livus/bimfo/enclosure/decals/decals.tex

% Decal sheet for the stop display replica, printed 1:1 on A4.
% Build: python make_matrix.py && xelatex decals.tex   (needs tikz, fontspec, pifont; run xelatex
% twice on a fresh checkout: the pages are placed with remember picture)
% All sizes in mm and taken from wl_display.scad; see the notes at each item.
% Font: Liberation Sans (fonts/, SIL OFL), the font the model engraves its labels in.
\documentclass{article}
\usepackage[a4paper, margin=0mm]{geometry}
\usepackage{tikz}
\usepackage{pifont}
\usepackage{graphicx}
\usepackage{fontspec}
\setsansfont{LiberationSans}[Path=fonts/, Extension=.ttf, UprightFont=*-Regular, BoldFont=*-Bold]
\renewcommand{\familydefault}{\sfdefault}
\pagestyle{empty}
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
\definecolor{ledseam}{HTML}{030603}      % seams between the three modules
\definecolor{grassdark}{HTML}{2F6B1E}
\definecolor{grasslight}{HTML}{8CC63F}
\definecolor{dogbrown}{HTML}{8A5226}
\definecolor{boxgrey}{HTML}{C9CCC8}      % box grey (about RAL 7035): match it to your filament

% \ledmatrix{x}{y}: the lit area of the display (32.35 x 17.39 mm), generated by make_matrix.py
\input{matrix.tex}

% \dogsticker{cx}{cy}{radius}: round sticker of the dog campaign on the bins, drawn here:
% a terrier on grass holding the "Nimm ein Sackerl fuer mein Gackerl" sign
\newcommand{\dogsticker}[3]{%
  \begin{scope}[shift={(#1,#2)}, yscale=-1, scale=#3]
    \shade[inner color=grasslight, outer color=grassdark] (0,0) circle (1.08);
    \fill[dogbrown] (-0.42,0.42) -- (-0.12,0.66) -- (-0.30,0.80) -- (-0.58,0.62) -- cycle;   % ears
    \fill[dogbrown] (0.42,0.42) -- (0.12,0.66) -- (0.30,0.80) -- (0.58,0.62) -- cycle;
    \fill[white] (0,0.22) ellipse (0.40 and 0.44);                                           % head
    \fill[white] (0,-0.08) ellipse (0.27 and 0.22);                                          % muzzle
    \fill[dogbrown] (-0.17,0.34) ellipse (0.20 and 0.25);                                    % patch
    \fill[black] (-0.15,0.27) circle (0.05) (0.15,0.27) circle (0.05);                       % eyes
    \fill[black] (0,0.02) ellipse (0.08 and 0.06);                                           % nose
    \fill[black!85] (-0.72,-0.36) rectangle (0.72,-0.70);                                    % sign
    \fill[white] (-0.36,-0.36) ellipse (0.11 and 0.08) (0.36,-0.36) ellipse (0.11 and 0.08); % paws
    \node[text=white, font=\bfseries\fontsize{1.05}{1.3}\selectfont, align=center, inner sep=0]
      at (0,-0.53) {NIMM EIN SACKERL\\F\"UR MEIN GACKERL};
    \draw[white, line width=0.15mm] (0,0) circle (1);
    \draw[cut, line width=0.08] (0,0) circle (1);
  \end{scope}}

% a filled decal of w x h, with 0.3 mm of colour past the cut line, and the cut line
% (y runs down the page)
\newcommand{\decal}[5]{% x, y (top left), w, h, colour
  \fill[#5] (#1-0.3, #2-0.3) rectangle (#1+#3+0.3, #2+#4+0.3);
  \draw[cut, line width=0.08] (#1, #2) rectangle (#1+#3, #2+#4);
}

% Box labels "Linie" / "Abfahrt in Minuten", for clear decal film: the model's own
% font (Liberation Sans Bold), scaled to the label as measured on the model:
% "Abfahrt in Minuten" 1.835 mm tall and 21.51 mm wide (21.38 mm of ink plus the
% sidebearings). OpenSCAD sets text about 4 % narrower than the font's own widths, so
% the two directions are scaled separately. One strip per face, as wide as
% the window (33.55 mm): "Linie" flush left, "Abfahrt in Minuten" flush right.
\newlength{\labh}
\newlength{\labw}
\newcommand{\labscale}{1}
\newcommand{\labxscale}{1}
\newcommand{\labeltext}[1]{\scalebox{\labxscale}[\labscale]{\fontsize{10}{12}\selectfont\bfseries #1}}
\newcommand{\labelstrip}[4]{% x, y (top left), strip height, baseline above the strip's bottom edge
  % crop marks outside the corners: on clear film a cut line would stay visible
  \foreach \cx/\dx in {#1/-1, #1+33.55/1} \foreach \cy/\dy in {#2/-1, #2+#3/1} {
    \draw[cut, line width=0.1] (\cx+\dx*0.6, \cy) -- (\cx+\dx*2.2, \cy);
    \draw[cut, line width=0.1] (\cx, \cy+\dy*0.6) -- (\cx, \cy+\dy*2.2);
  }
  \node[anchor=base west, inner sep=0] at (#1, #2+#3-#4) {\labeltext{Linie}};
  \node[anchor=base east, inner sep=0] at (#1+33.55, #2+#3-#4) {\labeltext{Abfahrt in Minuten}};
}
% The same on box grey, for plain sticker paper: cut on the line; the strip reaches from
% the window's top edge to an edge of the model (the face's chamfer, the back cover's edge).
\newcommand{\labelstripgrey}[4]{% x, y (top left), strip height, baseline above the strip's bottom edge
  \decal{#1}{#2}{33.55}{#3}{boxgrey}
  \node[anchor=base west, inner sep=0] at (#1, #2+#3-#4) {\labeltext{Linie}};
  \node[anchor=base east, inner sep=0] at (#1+33.55, #2+#3-#4) {\labeltext{Abfahrt in Minuten}};
}

\begin{document}
\settoheight{\labh}{\fontsize{10}{12}\selectfont\bfseries Abfahrt in Minuten}
\settowidth{\labw}{\fontsize{10}{12}\selectfont\bfseries Abfahrt in Minuten}
\pgfmathsetmacro{\labscale}{1.835 * 2.845276 / \labh}
\pgfmathsetmacro{\labxscale}{21.51 * 2.845276 / \labw}
\settowidth{\labw}{\labeltext{Abfahrt in Minuten}}
\typeout{LABELS: scale \labxscale\space x \labscale, width of "Abfahrt in Minuten" \the\labw}
\begin{tikzpicture}[remember picture, overlay, x=1mm, y=1mm, shift={(current page.north west)}, yscale=-1]
  % yscale=-1: y runs down the page from the top edge

  % ---------------------------------------------------------------- title and instructions
  \node[anchor=north west, font=\bfseries\fontsize{14}{16}\selectfont] at (15, 12) {Bimfo -- decal sheet};
  \node[anchor=north west, text width=180mm, font=\fontsize{8}{10}\selectfont] at (15, 20) {%
    Print at \textbf{100\,\%} (``actual size'', no fit-to-page) on glossy sticker paper or waterslide decal
    paper, then check the scale bar below. Cut along the grey lines; the colour runs 0.3\,mm past them.
    Sizes are for the default model (pole on the right).};

  % scale check
  \draw[line width=0.25] (15, 37) -- (65, 37);
  \foreach \i in {0, 10, ..., 50} \draw[line width=0.25] (15+\i, 35.5) -- (15+\i, 37);
  \node[anchor=west, font=\fontsize{7}{8}\selectfont] at (68, 36.5) {must measure 50\,mm};

  % ---------------------------------------------------------------- display
  \node[anchor=north west, font=\bfseries\fontsize{9}{11}\selectfont] at (15, 46) {Display};

  % Front: on the face of screen_dummy (36 x 19.6). The lit area (32.35 x 17.39) is
  % centred on the window, 1.1 mm towards the antenna end (left, seen from the front).
  \decal{15}{55}{36}{19.6}{ledglass}
  \ledmatrix{15+18-1.1-16.175}{55+9.8-8.695}
  \node[anchor=north west, text width=60mm, font=\fontsize{7}{8.5}\selectfont] at (15, 77) {%
    \textbf{Front} -- static model: stick onto the face of \texttt{screen\_dummy}, edges flush.};

  % Back: into the mock window of the back cover (33.55 x 18.39), lit area centred
  \decal{85}{55}{33.55}{18.39}{ledglass}
  \ledmatrix{85+0.6}{55+0.5}
  \node[anchor=north west, text width=60mm, font=\fontsize{7}{8.5}\selectfont] at (85, 77) {%
    \textbf{Back} -- into the back cover's window. On an all-grey back: centred, 2.67\,mm from
    the cover's top and bottom edges, sides 0.9\,mm beyond the screw marks.};

  % spare front decal
  \decal{150}{55}{36}{19.6}{ledglass}
  \ledmatrix{150+18-1.1-16.175}{55+9.8-8.695}
  \node[anchor=north west, text width=40mm, font=\fontsize{7}{8.5}\selectfont] at (150, 77) {%
    Front, spare. Other stations: page~2.};

  % ---------------------------------------------------------------- bin (Mistkuebel)
  \node[anchor=north west, font=\bfseries\fontsize{9}{11}\selectfont] at (15, 90) {Mistk\"ubel};
  \node[anchor=north west, text width=180mm, font=\fontsize{8}{10}\selectfont] at (15, 96) {%
    Instead of the filament changes: the band wraps once round the bin between the two grooves,
    starting and ending at the back (the railing hides the joint). Paint the rim of the opening orange.};

  % Band: 6.7 mm between the grooves at 6.15 and 12.85 mm; round the bin there is
  % 65.3 to 66.5 mm, plus 1 mm overlap. Text in the middle, which lands on the front.
  \foreach \y [count=\n] in {108, 118} {
    \decal{15}{\y}{67.5}{6.7}{wienorange}
    \node[anchor=center, text=white, font=\bfseries\fontsize{6.2}{6.6}\selectfont, align=center]
      at (15+67.5/2, \y+6.7/2) {MISTTELEFON\\[-0.2mm]\ding{37}\,546\,48};
  }
  \node[anchor=north west, text width=67mm, font=\fontsize{7}{8.5}\selectfont] at (15, 126) {%
    \textbf{Band} (67.5 $\times$ 6.7\,mm), with a spare.};

  % Slogan stickers on the front, above the band, below the lid seam: 15 x 9 mm,
  % a yellow strip on top and the slogan in white, as on the real bins.
  \newcommand{\slogan}[4]{% x, y, line 1, line 2
    \decal{#1}{#2}{15}{9}{wienorange}
    \fill[wienyellow] (#1-0.3, #2-0.3) rectangle (#1+15+0.3, #2+1.7);
    \draw[cut, line width=0.08] (#1, #2) rectangle (#1+15, #2+9);
    \node[anchor=center, text=black, font=\fontsize{2.1}{2.5}\selectfont] at (#1+7.5, #2+0.85) {Du hast es in der Hand. Bau keinen Mist.};
    \node[anchor=center, text=white, font=\bfseries\fontsize{6.4}{7}\selectfont, align=center]
      at (#1+7.5, #2+5.3) {#3\\[-0.3mm]#4};
  }
  \slogan{95}{108}{I TRAM}{VON MIST!}
  \slogan{115}{108}{BITTE}{F\"UTTERN!}
  \slogan{135}{108}{EIN-}{WURF}
  \slogan{155}{108}{I TRAM}{VON MIST!}
  \node[anchor=north west, text width=90mm, font=\fontsize{7}{8.5}\selectfont] at (95, 120) {%
    \textbf{Slogan stickers} (15 $\times$ 9\,mm): pick one; it goes on the front, centred, its top
    edge about 2\,mm below the lid seam.};

  % Ash tube tip: 3.5 mm tall, round the 3.2 mm tube (10.05 mm) plus overlap
  \foreach \x in {95, 110, 125, 140} {
    \decal{\x}{132}{10.6}{3.5}{wienorange}
  }
  \node[anchor=north west, text width=90mm, font=\fontsize{7}{8.5}\selectfont] at (95, 138) {%
    \textbf{Ash tube tip} (10.6 $\times$ 3.5\,mm): wrap round the top of the ash tube, edge level with its top.};

  % Dog sticker: round, 5.5 mm, on the front between the slogan sticker and the band
  \foreach \x in {97.75, 105.75, 113.75} { \dogsticker{\x}{150.75}{2.75} }
  \node[anchor=north west, text width=90mm, font=\fontsize{7}{8.5}\selectfont] at (95, 156) {%
    \textbf{Dog sticker} (\O{}\,5.5\,mm), from the city's dog-mess campaign: on the front,
    centred between the slogan sticker and the band.};

  % ---------------------------------------------------------------- box labels
  \node[anchor=north west, font=\bfseries\fontsize{9}{11}\selectfont] at (15, 168) {Box labels};
  \node[anchor=north west, text width=180mm, font=\fontsize{8}{10}\selectfont] at (15, 174) {%
    If you print the labels in the box colour: black text on \textbf{clear} decal film (waterslide or clear
    sticker film). Cut along the corner marks; place the strip's ends flush with the window's sides and
    its bottom edge on the window's top edge.};

  % Front: baseline 1.29 mm above the window, text top 3.12 mm (labels_solid in wl_display.scad)
  \foreach \x in {15, 60, 105} { \labelstrip{\x}{188}{3.6}{1.286} }
  \node[anchor=north west, text width=120mm, font=\fontsize{7}{8.5}\selectfont] at (150, 188) {%
    \textbf{Front} (33.55 $\times$ 3.6\,mm)};
  % Back: closer to the window, baseline 0.57 mm above it (back_face_2d)
  \foreach \x in {15, 60, 105} { \labelstrip{\x}{200}{2.9}{0.569} }
  \node[anchor=north west, text width=120mm, font=\fontsize{7}{8.5}\selectfont] at (150, 199.5) {%
    \textbf{Back} (33.55 $\times$ 2.9\,mm)};

  % Grey, for plain sticker paper. Front: window top edge to the start of the face's
  % 0.5 mm chamfer (13.56 - 0.5 - 9.195 = 3.865 mm); back: to the back cover's edge
  % (11.86 - 9.195 = 2.665 mm). Same text positions as above.
  \node[anchor=north west, text width=180mm, font=\fontsize{8}{10}\selectfont] at (15, 210) {%
    \textbf{On plain sticker paper:} the grey strips below. Ends flush with the window's sides, bottom
    edge on the window's top edge; the front strip then reaches up to the face's chamfer, the back strip
    to the edge of the back cover. Compare the grey with your print first (\texttt{boxgrey} in decals.tex).};
  \foreach \x in {15, 60, 105} { \labelstripgrey{\x}{226}{3.865}{1.286} }
  \node[anchor=north west, text width=120mm, font=\fontsize{7}{8.5}\selectfont] at (150, 226.5) {%
    \textbf{Front, grey} (33.55 $\times$ 3.87\,mm)};
  \foreach \x in {15, 60, 105} { \labelstripgrey{\x}{236}{2.665}{0.569} }
  \node[anchor=north west, text width=120mm, font=\fontsize{7}{8.5}\selectfont] at (150, 235.5) {%
    \textbf{Back, grey} (33.55 $\times$ 2.67\,mm)};

  % ---------------------------------------------------------------- footer
  \node[anchor=south west, text width=180mm, font=\fontsize{6.5}{8}\selectfont, text=cut] at (15, 287) {%
    Display: amber LED matrix in the layout of the original stop displays, as in the firmware's
    Wiener Linien style (faces drawn after photos of the displays), trams 1 and 62 as at Wiedner Hauptstra\ss{}e. Bin texts after the City of Vienna's
    litter bins; dog sticker drawn after its campaign; no logos. Source: enclosure/decals in the Bimfo repository.};
\end{tikzpicture}

\newpage
% ---------------------------------------------------------------- page 2: display variants
\begin{tikzpicture}[remember picture, overlay, x=1mm, y=1mm, shift={(current page.north west)}, yscale=-1]
  \node[anchor=north west, font=\bfseries\fontsize{14}{16}\selectfont] at (15, 12) {Bimfo -- display variants for real stations};
  \node[anchor=north west, text width=180mm, font=\fontsize{8}{10}\selectfont] at (15, 20) {%
    The same front and back decals, showing other tram stops. Each display belongs to one platform and
    shows the next tram of each line once. Print at \textbf{100\,\%}, as page~1.};

  % one row per station: front decal, back decal, caption
  \foreach \v [count=\n] in {A, B, C, D, E} {
    \pgfmathsetmacro{\y}{34 + (\n - 1) * 30}
    \decal{15}{\y}{36}{19.6}{ledglass}
    \csname ledmatrix\v\endcsname{15+18-1.1-16.175}{\y+9.8-8.695}
    \decal{60}{\y}{33.55}{18.39}{ledglass}
    \csname ledmatrix\v\endcsname{60+0.6}{\y+0.5}
    \node[anchor=north west, text width=82mm, font=\fontsize{8}{10}\selectfont, align=left] at (103, \y) {%
      \textbf{\csname stationname\v\endcsname}\\
      \csname stationnote\v\endcsname\\[1mm]
      Lines \csname stationlines\v\endcsname\\[1mm]
      {\fontsize{7}{8.5}\selectfont Left: front (\texttt{screen\_dummy}), right: back window.}};
  }

  \node[anchor=south west, text width=180mm, font=\fontsize{6.5}{8}\selectfont, text=cut] at (15, 287) {%
    Paulanergasse as in the reference photo, from before line 1 was rerouted; the others are real departures
    from the Wiener Linien realtime API (data.wien.gv.at, CC BY 4.0), 27 October 2026.};
\end{tikzpicture}
\end{document}
