livus/bimfo/enclosure/decals/decals.pdf

# Bimfo – decal sheet

Print at 100 % (“actual size”, no fit-to-page) on glossy sticker paper or waterslide decal paper, then check the scale bar below. Cut along the grey lines; the colour runs 0.3 mm past them. Sizes are for the default model (pole on the right).

must measure 50 mm

Display

Front – static model: stick onto the face of screen_dummy, edges flush.

Back – into the back cover’s window. On an all-grey back: centred, 2.67 mm from the cover’s top and bottom edges, sides 0.9 mm beyond the screw marks.

Front, spare. Other stations: page 2.

Mistkübel

Instead of the filament changes: the band wraps once round the bin between the two grooves, starting and ending at the back (the railing hides the joint). Paint the rim of the opening orange.

MISTTELEFON
☎ 546 48

MISTTELEFON
☎ 546 48

Band (67.5 × 6.7 mm), with a spare.

Du hast es in der Hand. Bau keinen Mist.
I TRAM
VON MIST!

Du hast es in der Hand. Bau keinen Mist.
BITTE
FÜTTERN!

Du hast es in der Hand. Bau keinen Mist.
EIN-WURF

Du hast es in der Hand. Bau keinen Mist.
I TRAM
VON MIST!

Slogan stickers (15 × 9 mm): pick one; it goes on the front, centred, its top edge about 2 mm below the lid seam.

Ash tube tip (10.6 × 3.5 mm): wrap round the top of the ash tube, edge level with its top.

NIMM EIN SACKERL
FÜR MEIN GACKERL

NIMM EIN SACKERL
FÜR MEIN GACKERL

NIMM EIN SACKERL
FÜR MEIN GACKERL

Dog sticker (Ø 5.5 mm), from the city’s dog-mess campaign: on the front, centred between the slogan sticker and the band.

Box labels

If you print the labels in the box colour: black text on clear decal film (waterslide or clear sticker film). Cut along the corner marks; place the strip’s ends flush with the window’s sides and its bottom edge on the window’s top edge.

Linie | Abfahrt in Minuten | Linie | Abfahrt in Minuten | Linie | Abfahrt in Minuten | Front (33.55 × 3.6 mm)
Linie | Abfahrt in Minuten | Linie | Abfahrt in Minuten | Linie | Abfahrt in Minuten | Back (33.55 × 2.9 mm)

On plain sticker paper: the grey strips below. Ends flush with the window’s sides, bottom edge on the window’s top edge; the front strip then reaches up to the face’s chamfer, the back strip to the edge of the back cover. Compare the grey with your print first (boxgrey in decals.tex).

Linie | Abfahrt in Minuten | Linie | Abfahrt in Minuten | Linie | Abfahrt in Minuten | Front, grey (33.55 × 3.87 mm)
Linie | Abfahrt in Minuten | Linie | Abfahrt in Minuten | Linie | Abfahrt in Minuten | Back, grey (33.55 × 2.67 mm)

Display: amber LED matrix in the layout of the original stop displays, as in the firmware’s Wiener Linien style (faces drawn after photos of the displays), trams 1 and 62 as at Wiedner Hauptstraße. Bin texts after the City of Vienna’s litter bins; dog sticker drawn after its campaign; no logos. Source: enclosure/decals in the Bimfo repository.

# Bimfo – display variants for real stations

The same front and back decals, showing other tram stops. Each display belongs to one platform and shows the next tram of each line once. Print at 100 %, as page 1.

Paulanergasse
as in the reference photo
Lines 1, 62

Left: front (screen_dummy), right: back window.

Schottentor U
the Jonas-Reindl, lines 37 to 42
Lines 38, 40, 37

Left: front (screen_dummy), right: back window.

Oper, Karlsplatz U
Ring, towards Burgtheater
Lines 2, D, 1

Left: front (screen_dummy), right: back window.

Rathausplatz, Burgtheater
Ring, towards Oper
Lines 71, 1, D

Left: front (screen_dummy), right: back window.

Zentralfriedhof 2. Tor
at the main gate
Lines 11, 71

Left: front (screen_dummy), right: back window.

Paulanergasse as in the reference photo, from before line 1 was rerouted; the others are real departures from the Wiener Linien realtime API (data.wien.gv.at, CC BY 4.0), 27 October 2026.
