livus/bimfo/enclosure/stl/horn.stl

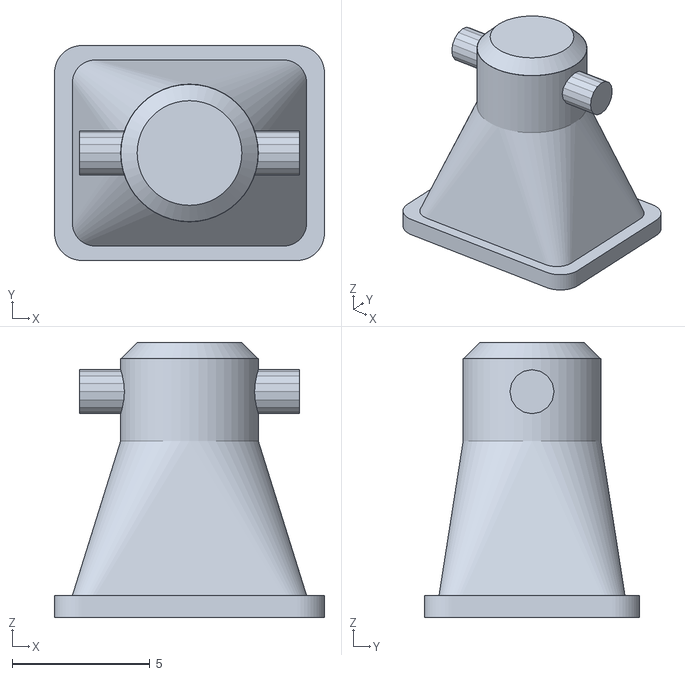
[picture p10: CAD file, 2026-10-30]
enclosure/stl/horn.stl
9.80 x 7.80 x 9.99
