livus/bimfo/enclosure/stl/fence.stl

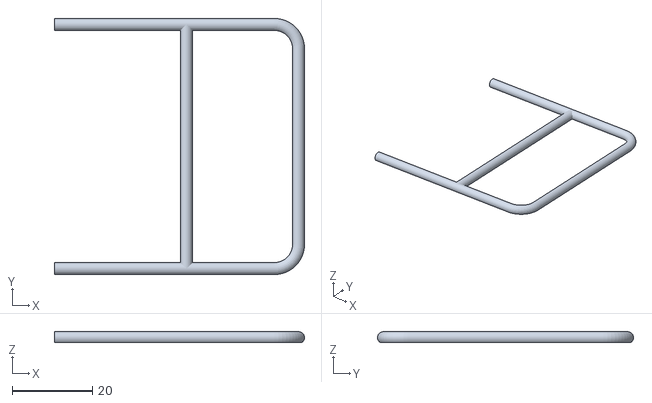
[picture p11: CAD file, 2026-10-27]
enclosure/stl/fence.stl
62.5 x 64.0 x 2.70
