livus/bimfo/enclosure/stl/can.stl

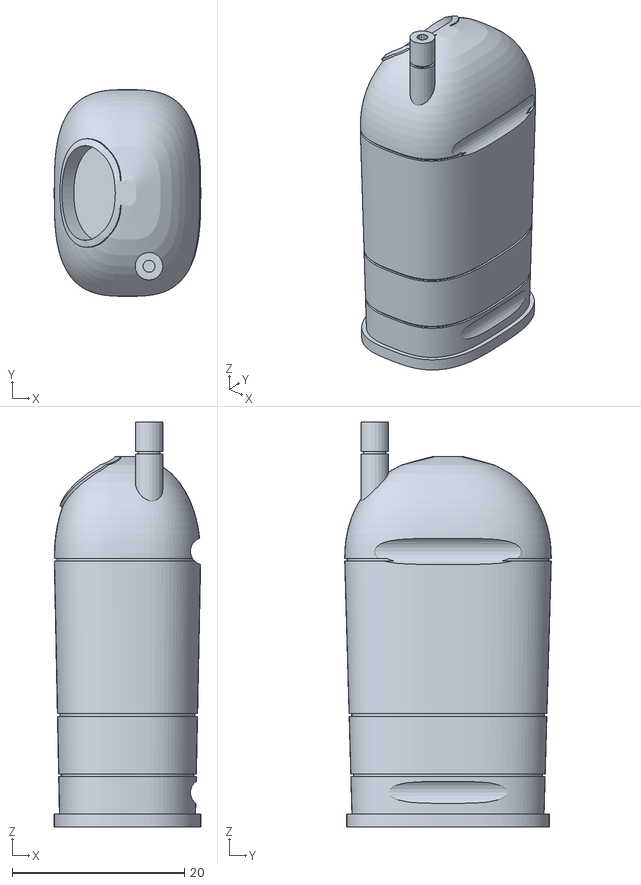
[picture p12: CAD file, 2026-10-27]
enclosure/stl/can.stl
17.0 x 24.0 x 47.0
