livus/bimfo/enclosure/stl/back_closed.stl

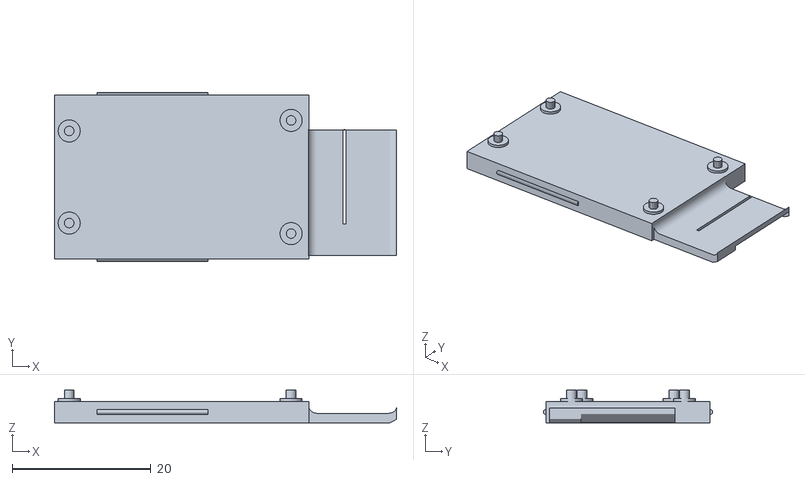
[picture p13: CAD file, 2026-10-27]
enclosure/stl/back_closed.stl
49.3 x 24.4 x 4.69
