livus/bimfo/enclosure/stl/cap.stl

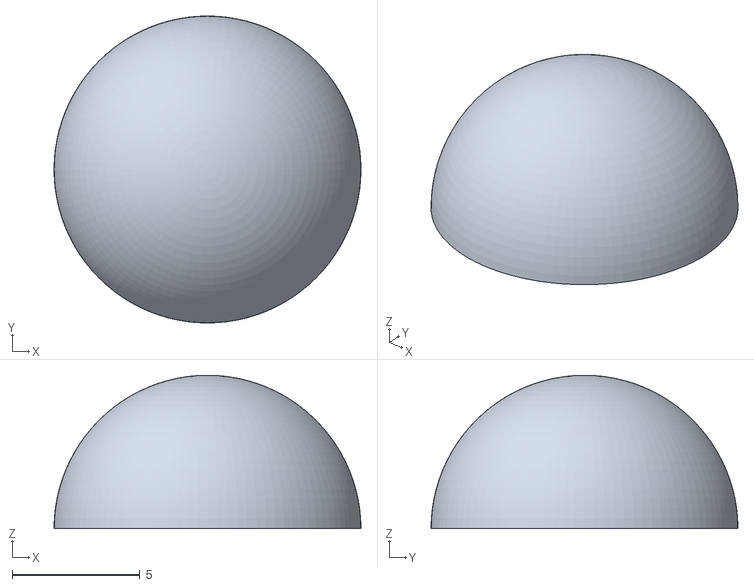
[picture p14: CAD file, 2026-10-27]
enclosure/stl/cap.stl
12.0 x 12.0 x 6.00
