livus/bimfo/enclosure/stl/base_strip.stl

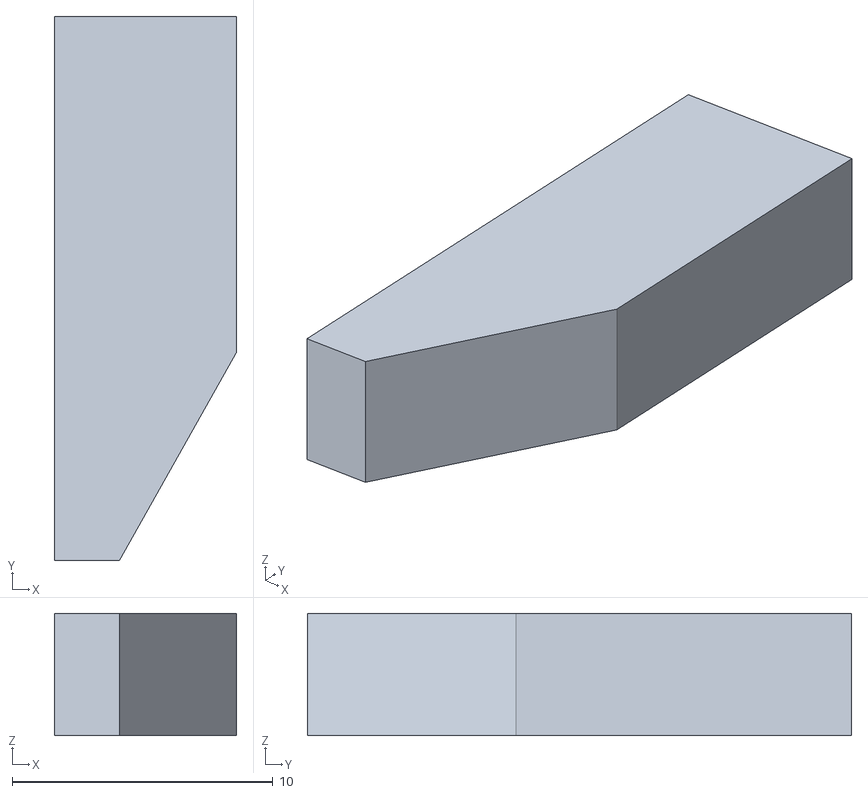
[picture p15: CAD file, 2026-10-27]
enclosure/stl/base_strip.stl
7.00 x 20.9 x 4.70
