livus/bimfo/enclosure/stl/labels.stl

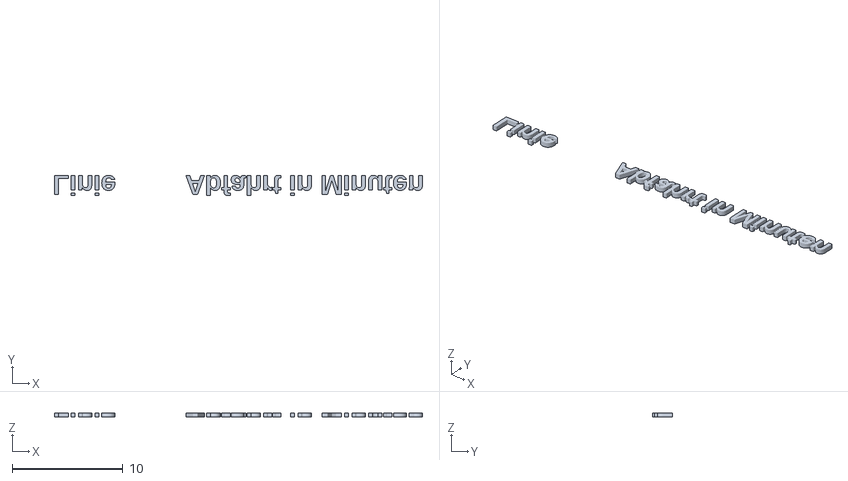
[picture p16: CAD file, 2026-10-27]
enclosure/stl/labels.stl
33.3 x 1.84 x 0.4
