livus/bimfo/enclosure/stl/speaker_bracket.stl

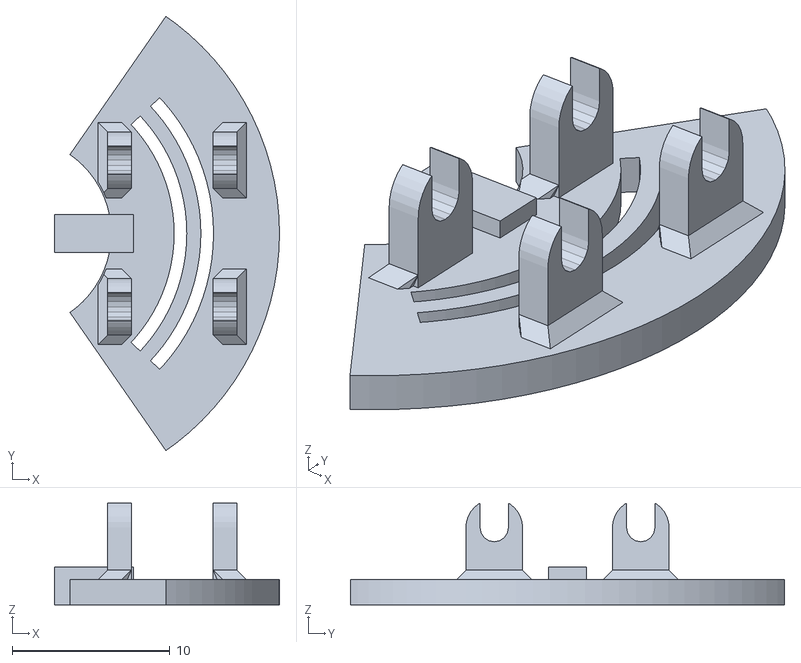
[picture p17: CAD file, 2026-10-27]
enclosure/stl/speaker_bracket.stl
14.3 x 27.5 x 6.45
