livus/bimfo/enclosure/stl/pole_top.stl

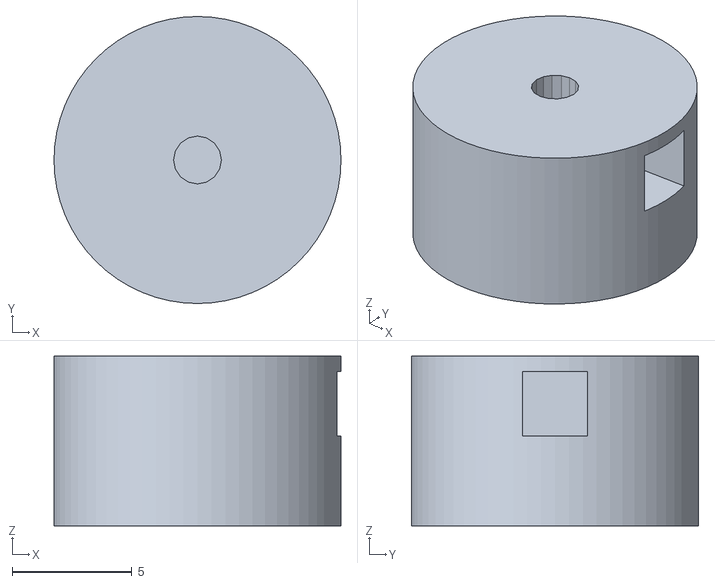
[picture p18: CAD file, 2026-10-27]
enclosure/stl/pole_top.stl
12.0 x 12.0 x 7.10
