livus/bimfo/enclosure/stl/pole_cover.stl

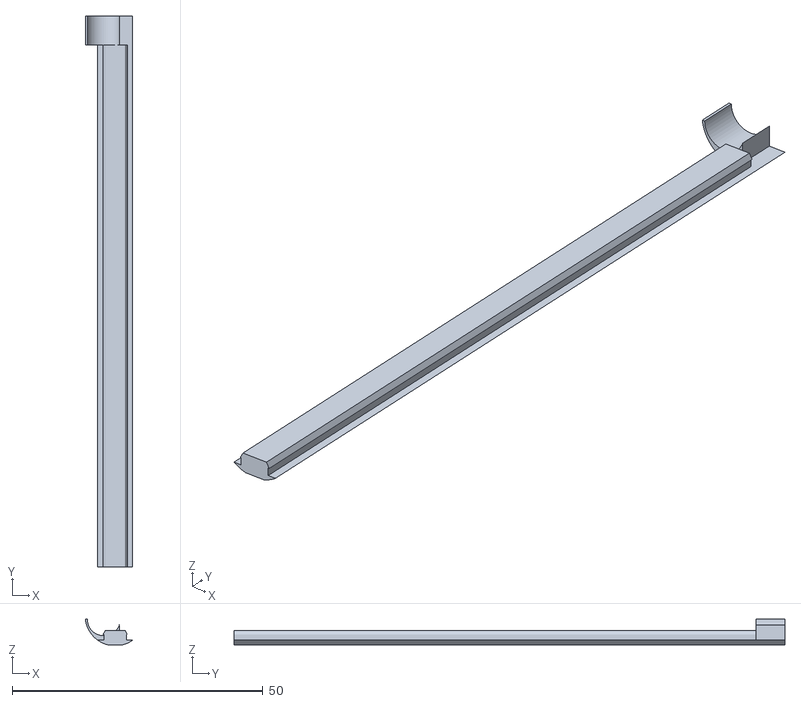
[picture p19: CAD file, 2026-10-27]
enclosure/stl/pole_cover.stl
9.44 x 109.8 x 5.10
