livus/bimfo/enclosure/stl/back_closed_labels.stl

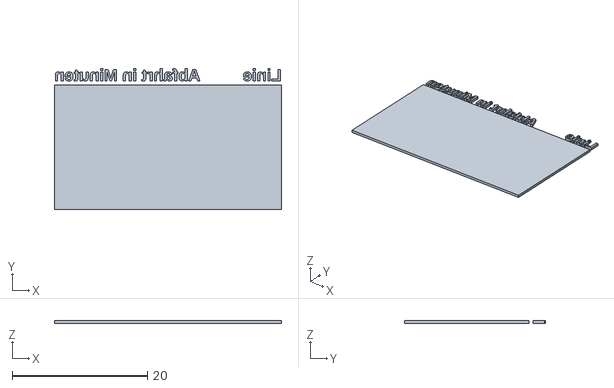
[picture p20: CAD file, 2026-10-27]
enclosure/stl/back_closed_labels.stl
33.5 x 20.8 x 0.4
