livus/bimfo/enclosure/stl/back.stl

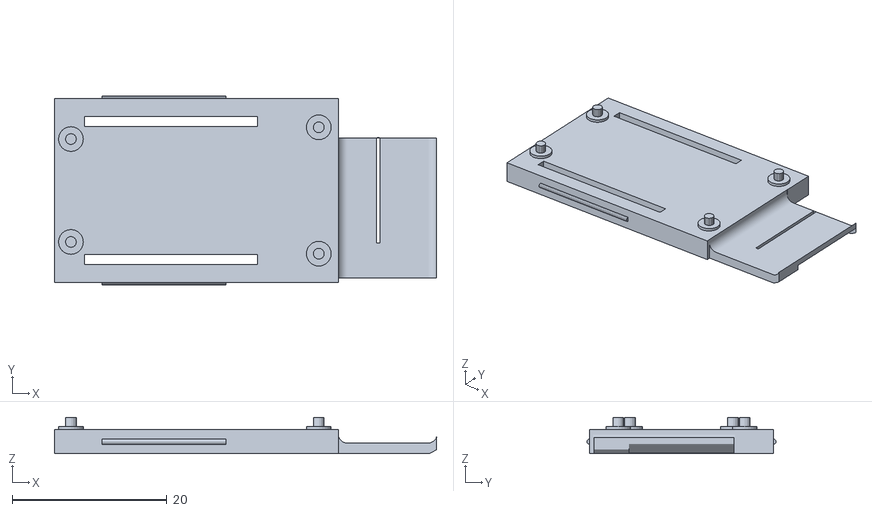
[picture p21: CAD file, 2026-10-27]
enclosure/stl/back.stl
49.3 x 24.4 x 4.69
