livus/bimfo/enclosure/stl/base.stl

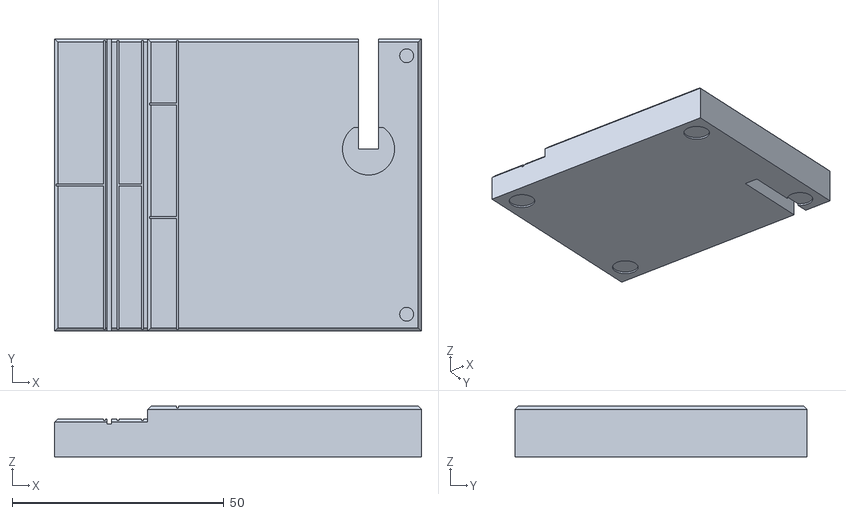
[picture p22: CAD file, 2026-10-27]
enclosure/stl/base.stl
86.6 x 69.0 x 12.0
