livus/bimfo/enclosure/stl/fence_half.stl

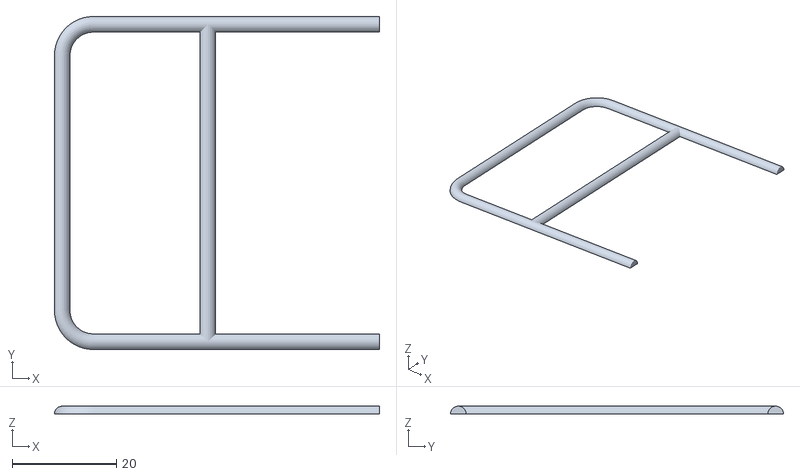
[picture p23: CAD file, 2026-10-27]
enclosure/stl/fence_half.stl
62.5 x 64.0 x 1.50
