livus/bimfo/enclosure/stl/cabletest_pole.stl

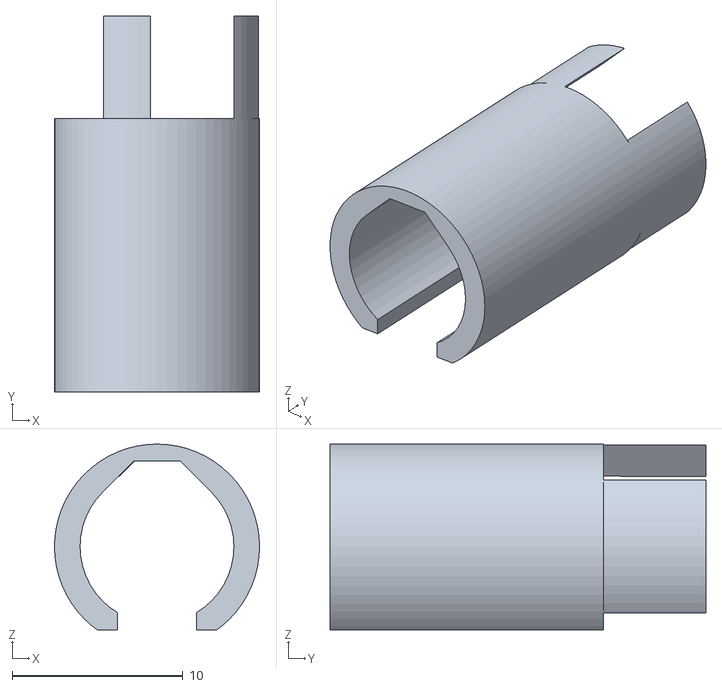
[picture p24: CAD file, 2026-10-27]
enclosure/stl/cabletest_pole.stl
12.0 x 22.0 x 10.9
