livus/bimfo/enclosure/stl/back_labels.stl

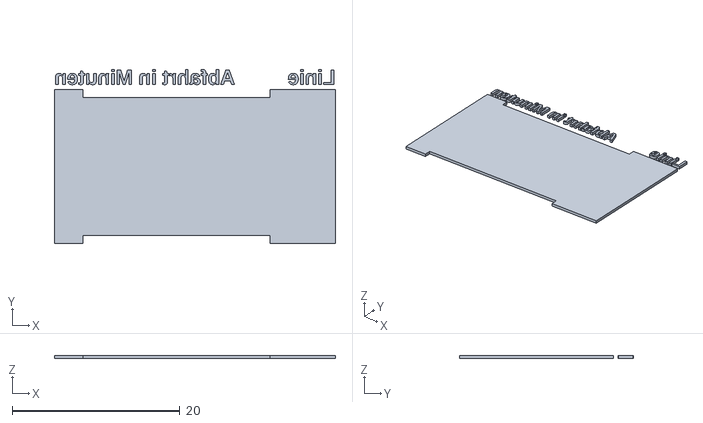
[picture p25: CAD file, 2026-10-27]
enclosure/stl/back_labels.stl
33.5 x 20.8 x 0.4
