livus/bimfo/enclosure/stl/cabletest_cover.stl

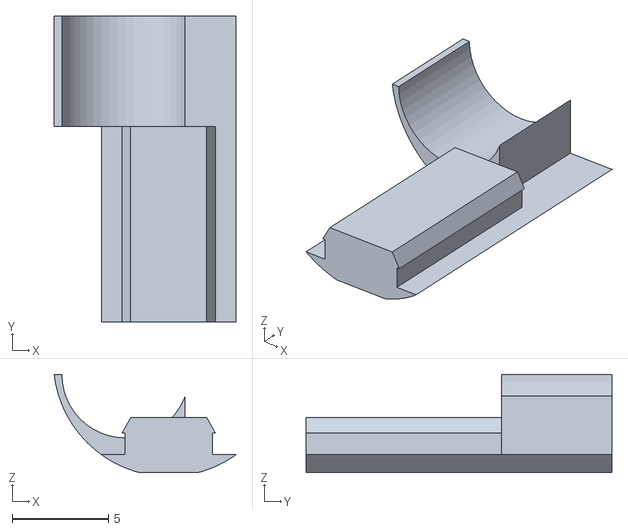
[picture p26: CAD file, 2026-10-27]
enclosure/stl/cabletest_cover.stl
9.44 x 15.9 x 5.10
