livus/bimfo/enclosure/stl/cabletest.stl

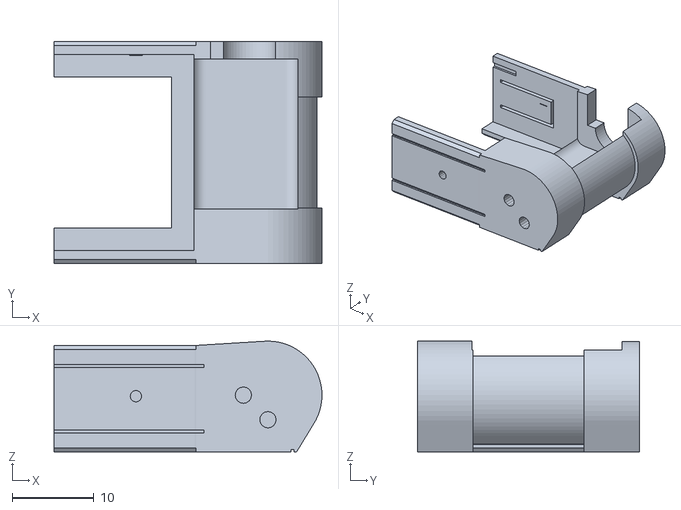
[picture p27: CAD file, 2026-10-27]
enclosure/stl/cabletest.stl
32.7 x 27.1 x 13.5
