livus/bimfo/enclosure/stl/pole.stl

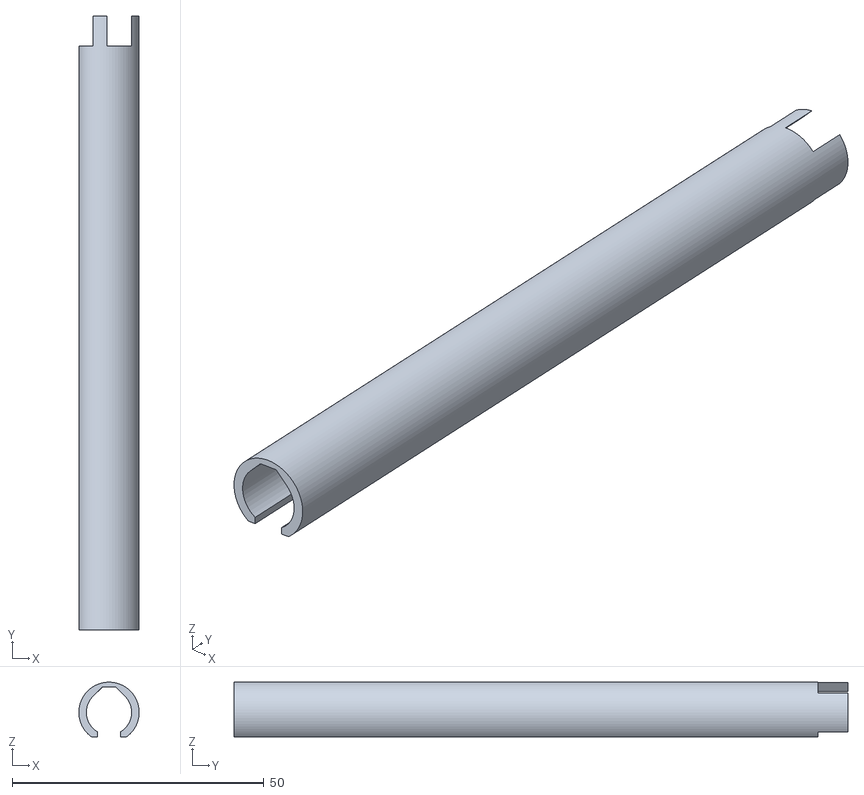
[picture p28: CAD file, 2026-10-27]
enclosure/stl/pole.stl
12.0 x 122.0 x 10.9
