livus/bimfo/enclosure/stl/fittest.stl

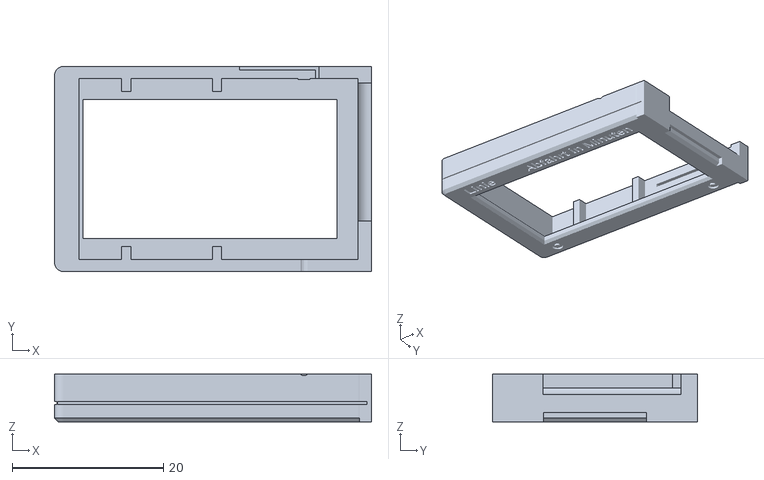
[picture p29: CAD file, 2026-10-27]
enclosure/stl/fittest.stl
41.9 x 27.1 x 6.30
