livus/bimfo/enclosure/stl/screen_dummy.stl

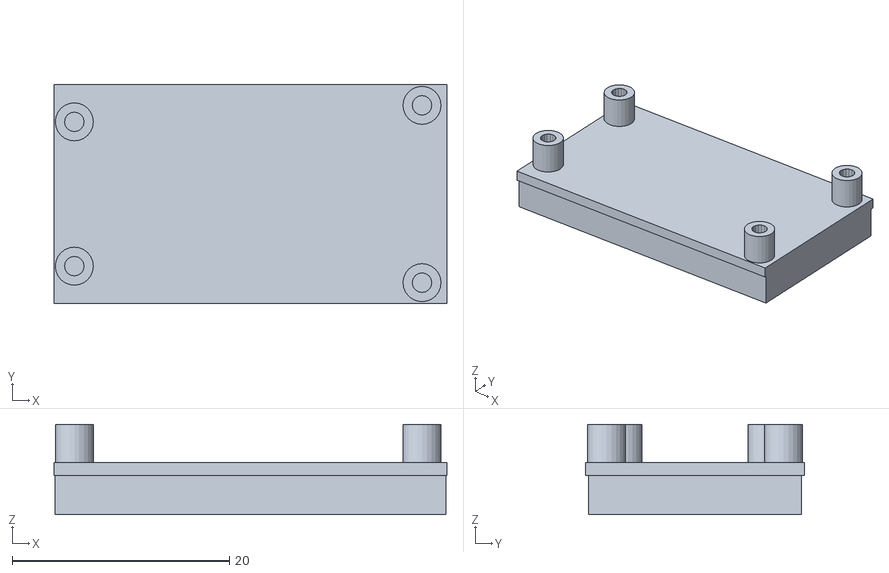
[picture p30: CAD file, 2026-10-27]
enclosure/stl/screen_dummy.stl
36.2 x 20.1 x 8.30
