livus/bimfo/enclosure/stl/shell.stl

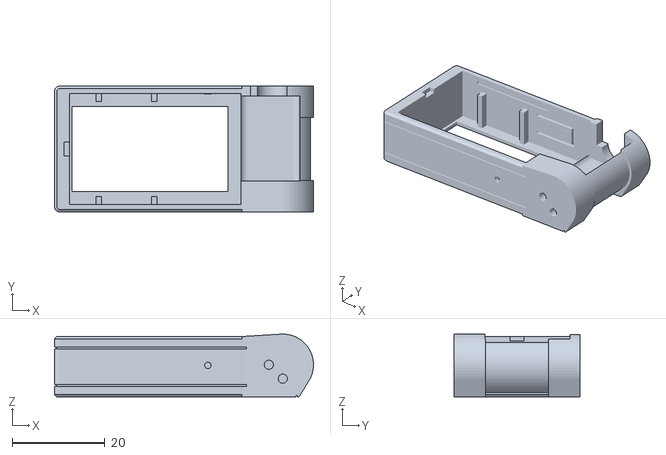
[picture p31: CAD file, 2026-10-27]
enclosure/stl/shell.stl
55.7 x 27.1 x 13.5
