livus/bimfo/enclosure/img/makerworld/back.png

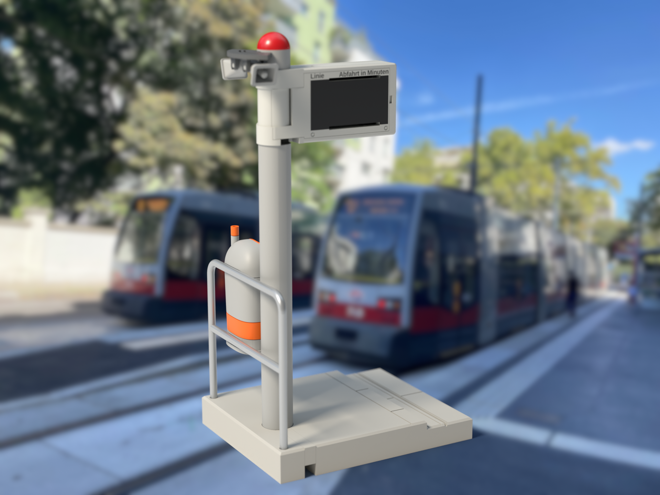
enclosure/img/makerworld/back.png
