livus/bimfo/enclosure/img/makerworld/cover_mobile.jpg

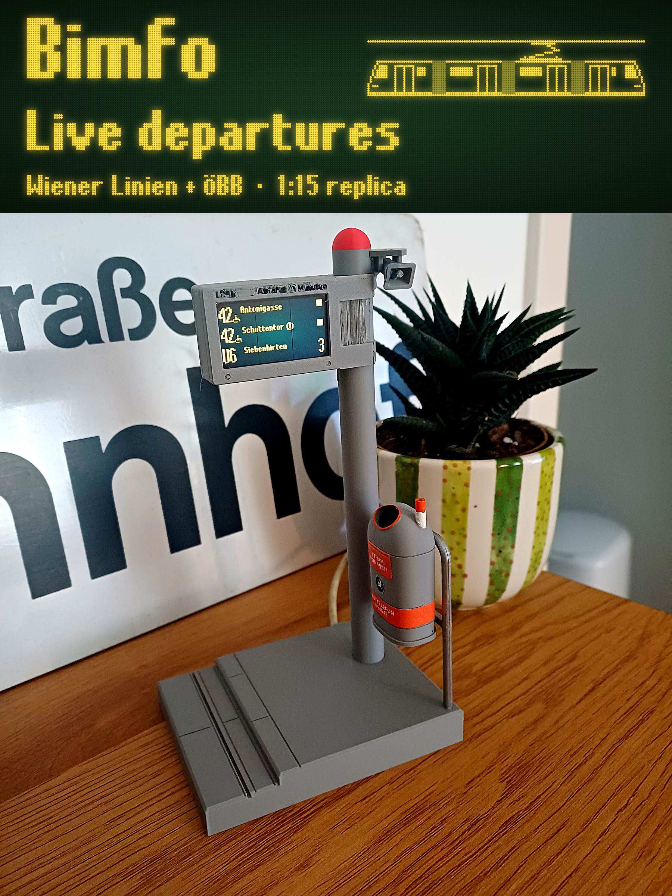
enclosure/img/makerworld/cover_mobile.jpg
