livus/bimfo/enclosure/img/makerworld/cover_web.jpg

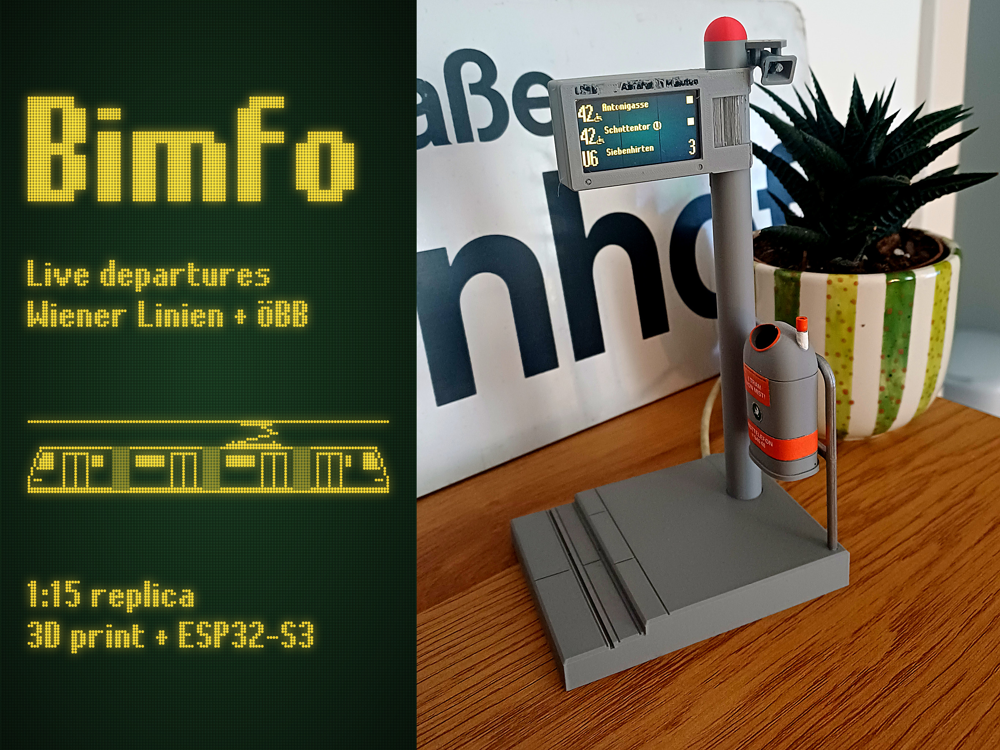
enclosure/img/makerworld/cover_web.jpg
