livus/bimfo/enclosure/img/makerworld/detail.png

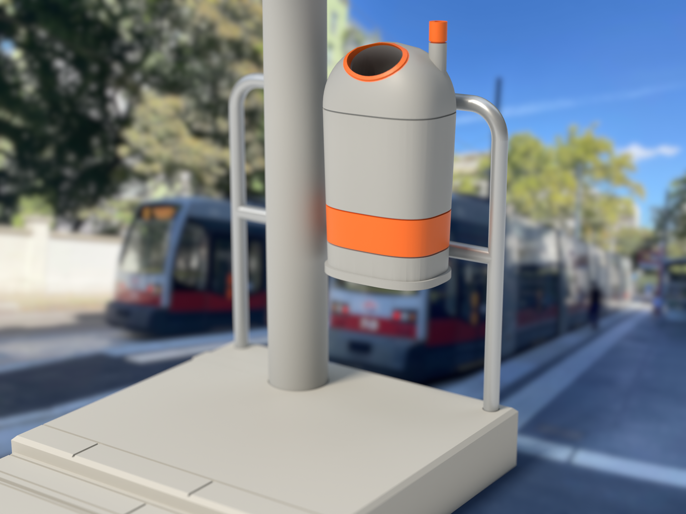
enclosure/img/makerworld/detail.png
