livus/bimfo/enclosure/img/makerworld/display.png

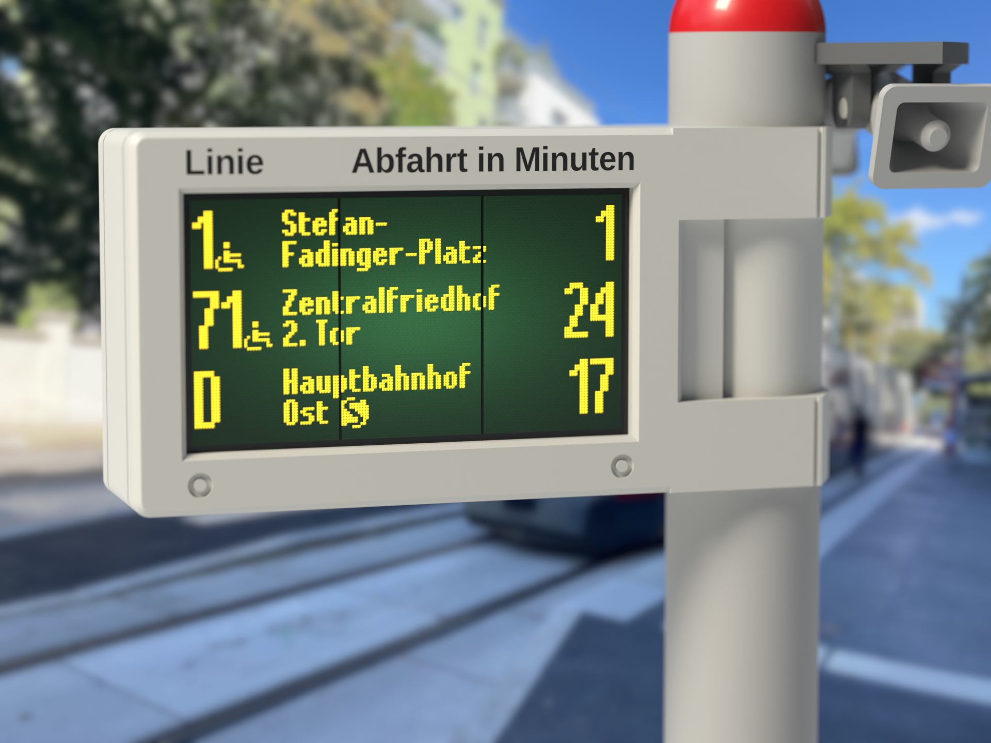
enclosure/img/makerworld/display.png
