livus/bimfo/enclosure/img/makerworld/exploded_night.png

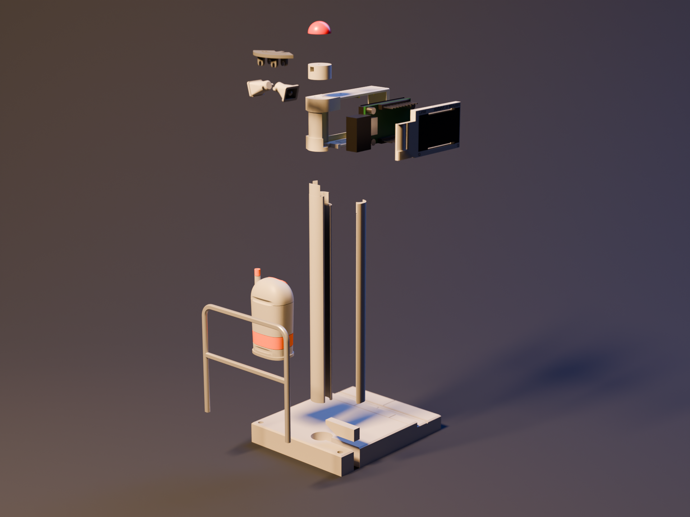
enclosure/img/makerworld/exploded_night.png
