livus/bimfo/enclosure/img/makerworld/front_1.jpg

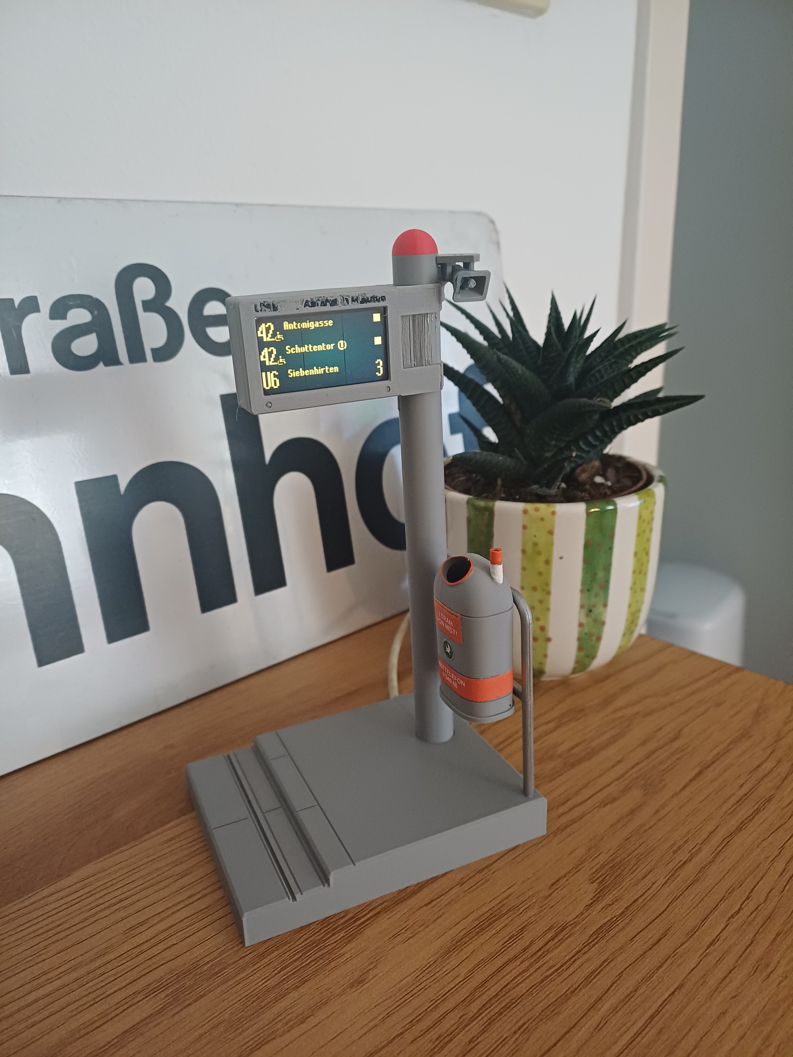
enclosure/img/makerworld/front_1.jpg
