livus/bimfo/enclosure/img/makerworld/night.png

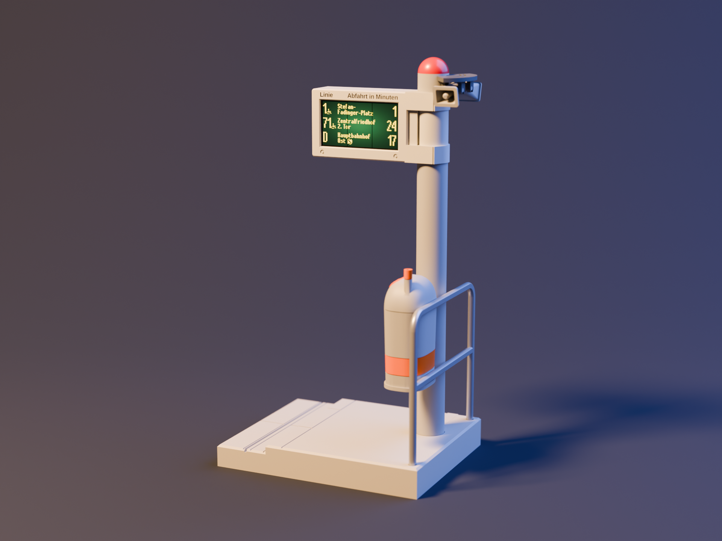
enclosure/img/makerworld/night.png
