livus/bimfo/enclosure/img/makerworld/styles.png

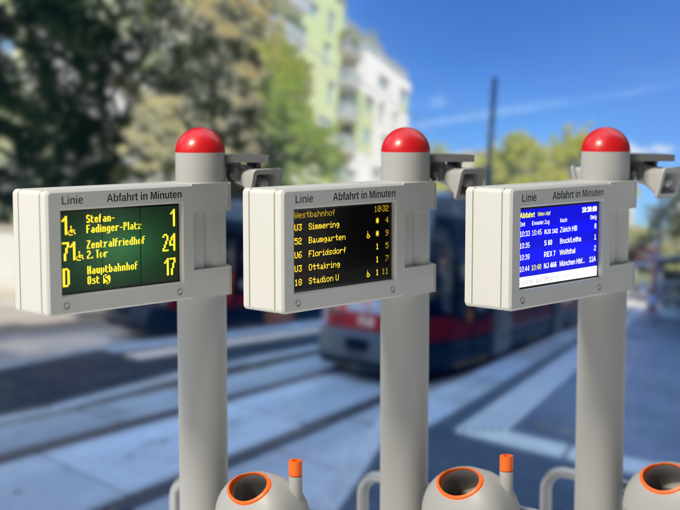
enclosure/img/makerworld/styles.png
