livus/bimfo/(commit log)

2026-10-30 Update model
    [horn.stl, wl_display.scad]
2026-10-30 Realistic Wiener Linien display
    [D_single_color_without_esp.3mf]
2026-10-31 Cleanup + redners + link MakerWorld
    [D_single_color_without_esp.3mf, back_closed_with_labels.3mf, back_with_labels.3mf, shell_with_labels.3mf]
