livus/bimfo/(notices)

Notices in the files:
README.md:
Enclosure: CC BY-NC-SA 4.0
